DumpName/i2c-gas-meter/tiny/gas_meter-attiny/main.h

#ifndef MAIN_H
#define MAIN_H

#define CONTROL_PORT_DDR    DDRB
#define CONTROL_PORT        PORTB
#define CONTROL_PORT_PINS   PINB
#define SENSOR_PIN          PB4
#define SENSOR_VCC_PIN      PB3

#ifndef cbi
#define cbi(sfr, bit) (_SFR_BYTE(sfr) &= ~_BV(bit))
#endif

#ifndef sbi
#define sbi(sfr, bit) (_SFR_BYTE(sfr) |= _BV(bit))
#endif

#ifndef fbi
#define fbi(sfr, bit) (_SFR_BYTE(sfr) ^= _BV(bit))
#endif

#ifndef rbi
#define rbi(sfr, bit) (((sfr)>>(bit)) & 1)
#endif

#define FL_WD_TRIGGERED     0   // IC has been woken up by watchdog
#define FL_PREV_SENSOR_VAL  1   // previous sensor reading

#define LOG_MINUTES         30
#define LOG_FRAME_SECONDS   50
#define LOG_FRAMES          ( LOG_MINUTES * 60 / LOG_FRAME_SECONDS ) + 4

typedef struct pulse_log_t {
    uint16_t vcc;
    uint16_t ticks;
    uint8_t frames[LOG_FRAMES];
} pulse_log_t;

#endif
